gildobjanschi/ECP5_TQFP144_USB3318C_TX_AUDIO/3dmodels/DA101JC.stp

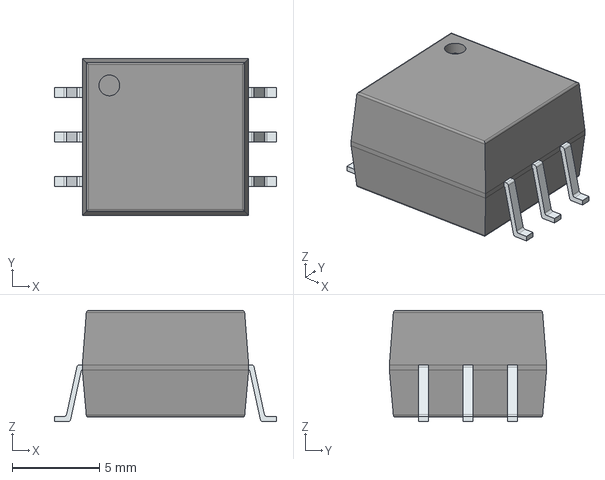
[picture p2: CAD file, 2024-07-15]
3dmodels/DA101JC.stp
12.7 x 9.00 x 6.35 mm
PinsArrayLR
