gildobjanschi/ECP5_TQFP144_USB3318C_TX_AUDIO/3dmodels/CUI_DEVICES_UJ2-BH-BL1-TH.step

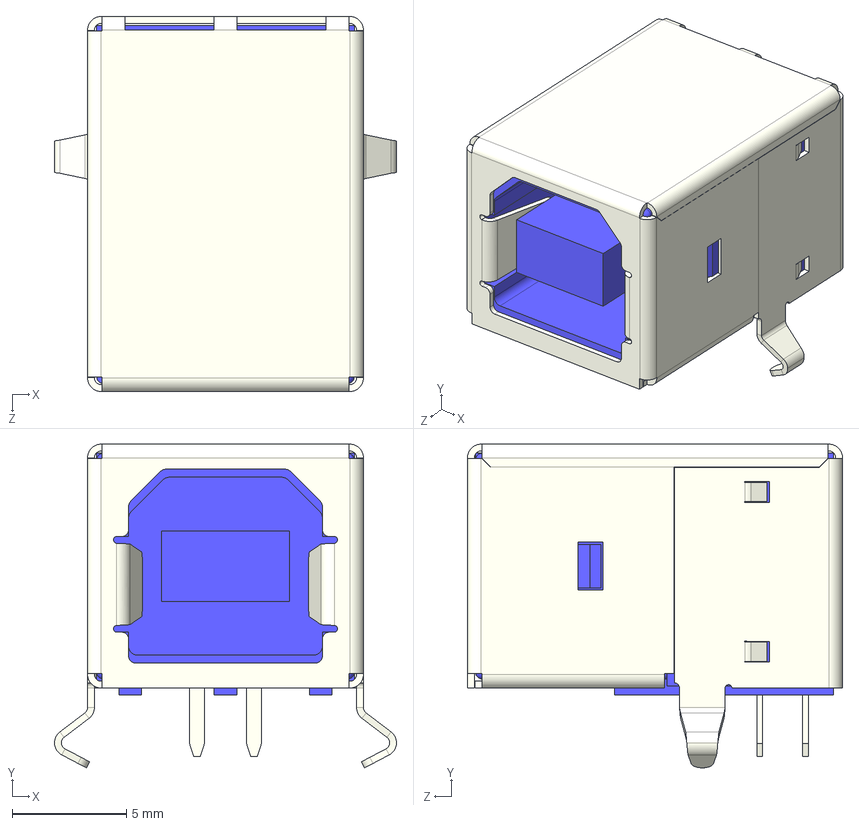
[picture p3: CAD file, 2024-07-15]
3dmodels/CUI_DEVICES_UJ2-BH-BL1-TH.step
15.0 x 14.2 x 16.5 mm
