gildobjanschi/ECP5_TQFP144_USB3318C_TX_AUDIO/3dmodels/0ZCG0075FF2C.STEP

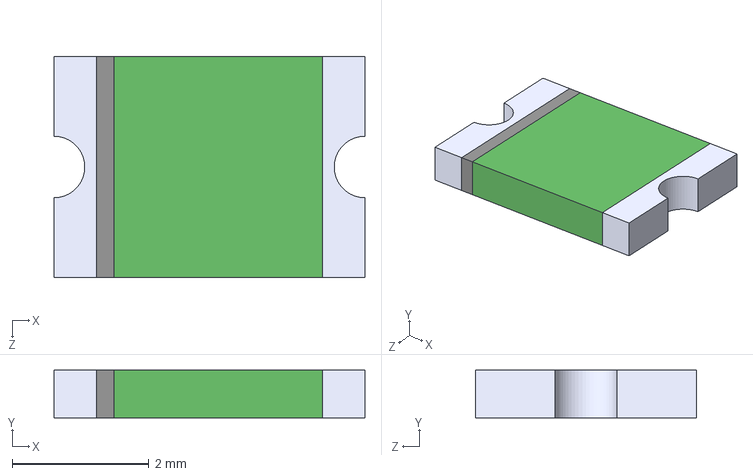
[picture p4: CAD file, 2024-07-15]
3dmodels/0ZCG0075FF2C.STEP
4.55 x 0.7 x 3.24 mm
