gildobjanschi/ECP5_TQFP144_USB3318C_TX_AUDIO/3dmodels/NC3FAAH2.STEP

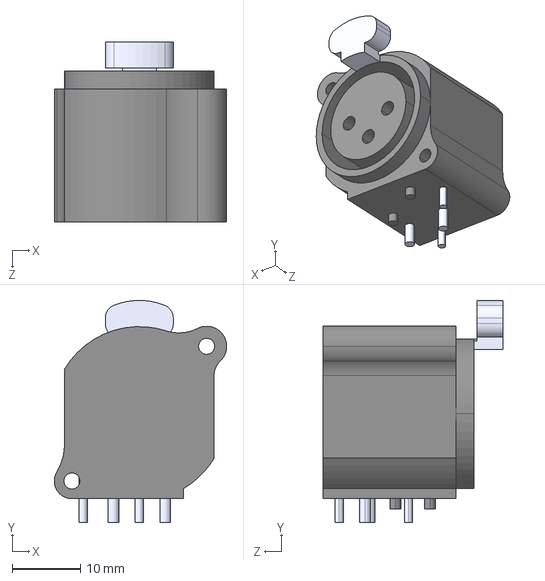
[picture p5: CAD file, 2024-07-15]
3dmodels/NC3FAAH2.STEP
25.3 x 32.6 x 26.4 mm
