gildobjanschi/ECP5_TQFP144_USB3318C_TX_AUDIO/3dmodels/CCHD-950-50-100_000_CRX.step

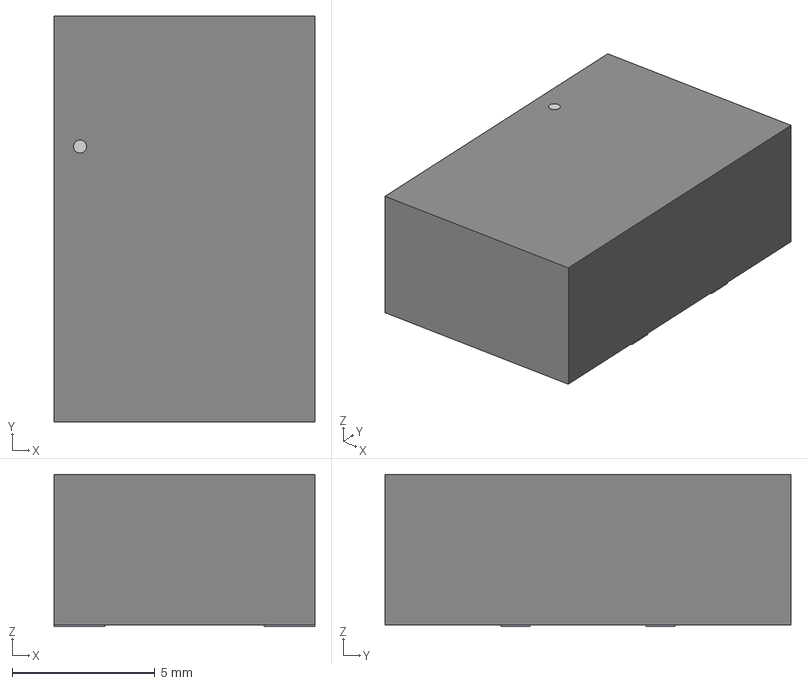
[picture p6: CAD file, 2024-07-15]
3dmodels/CCHD-950-50-100_000_CRX.step
9.14 x 14.2 x 5.34 mm
