gildobjanschi/ECP5_TQFP144_USB3318C_TX_AUDIO/3dmodels/551XX07.stp

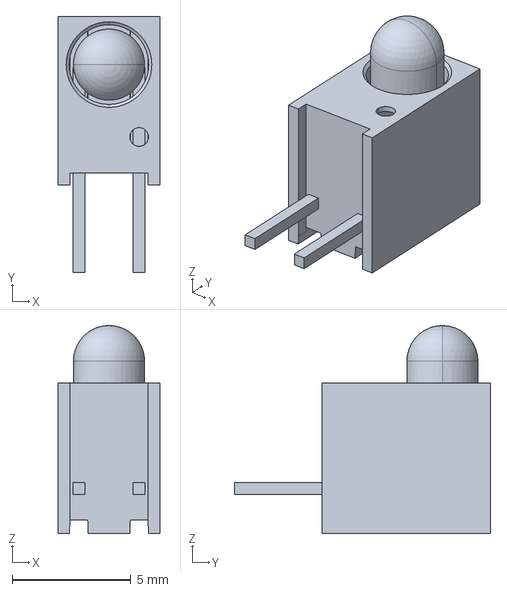
[picture p7: CAD file, 2024-07-15]
3dmodels/551XX07.stp
4.32 x 10.8 x 8.76 mm
