gildobjanschi/ECP5_TQFP144_USB3318C_TX_AUDIO/3dmodels/USB4105GFA120.step

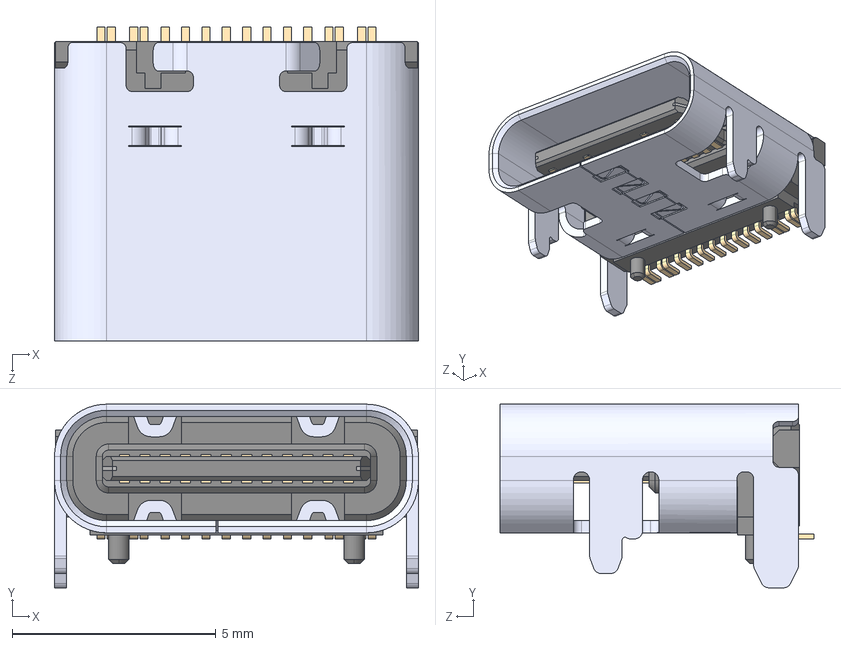
[picture p8: CAD file, 2024-07-15]
3dmodels/USB4105GFA120.step
8.94 x 4.51 x 7.71 mm
