gildobjanschi/ECP5_TQFP144_USB3318C_TX_AUDIO/3dmodels/W-PDFN-8-1EP_6x5mm_P1.27mm_EP3x3mm.step

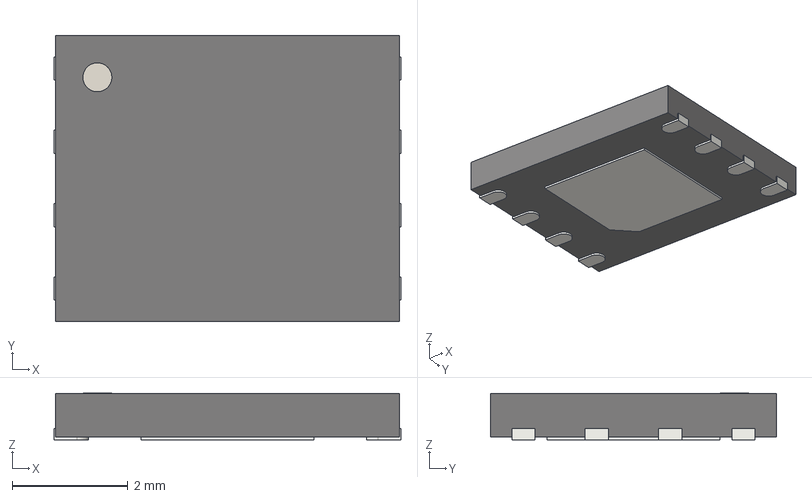
[picture p9: CAD file, 2024-07-15]
3dmodels/W-PDFN-8-1EP_6x5mm_P1.27mm_EP3x3mm.step
6.00 x 4.95 x 0.81 mm
b2c81738-8124-11ed-a8f2-acde48001122_part
b2c8199a-8124-11ed-a8f2-acde48001122_part
b2c81abc-8124-11ed-a8f2-acde48001122_part
b2c81b5c-8124-11ed-a8f2-acde48001122_part
