gildobjanschi/ECP5_TQFP144_USB3318C_TX_AUDIO/3dmodels/031-71052-1010.stp

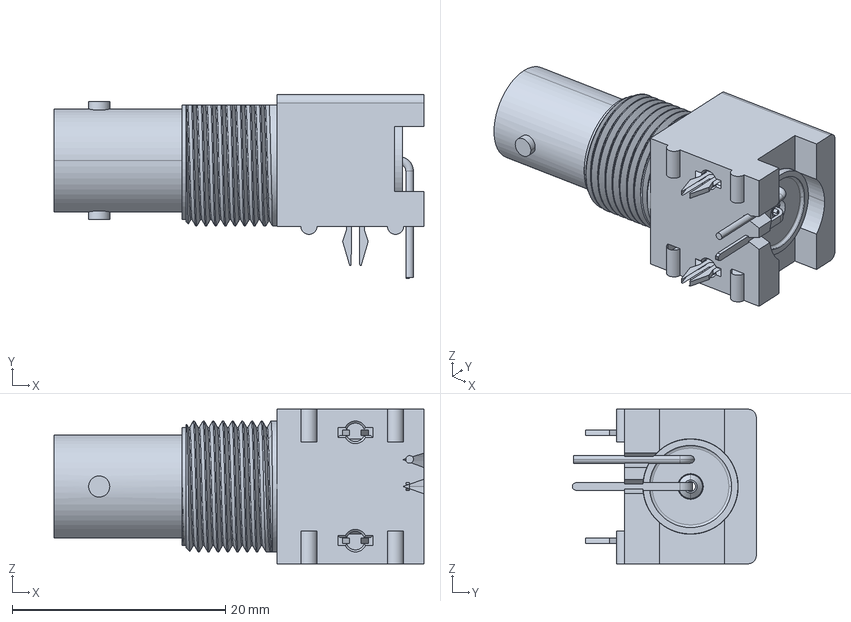
[picture p10: CAD file, 2024-07-15]
3dmodels/031-71052-1010.stp
34.7 x 17.2 x 14.5 mm
