gildobjanschi/ECP5_TQFP144_USB3318C_TX_AUDIO/3dmodels/PLR135_T10.stp

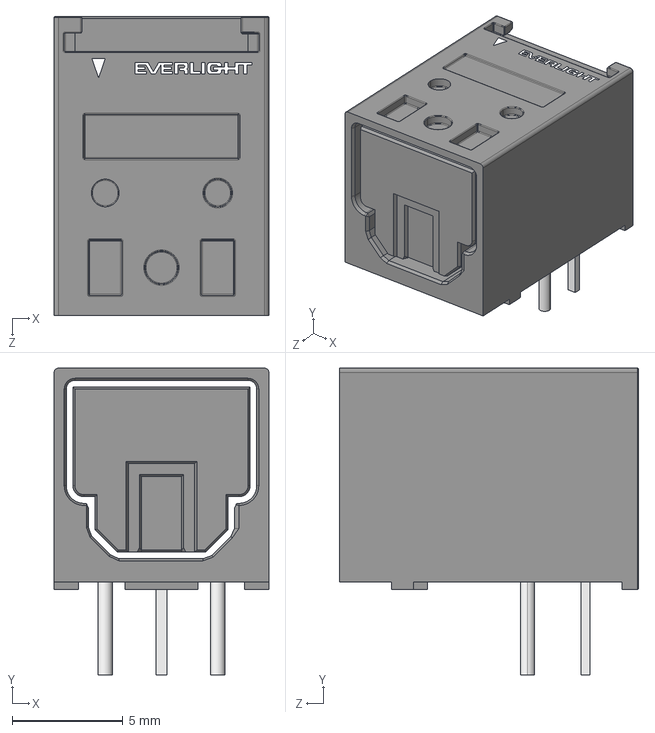
[picture p11: CAD file, 2024-07-15]
3dmodels/PLR135_T10.stp
9.70 x 13.9 x 13.5 mm
