gildobjanschi/ECP5_TQFP144_USB3318C_TX_AUDIO/3dmodels/QFN24_4X4MC_MCH.step

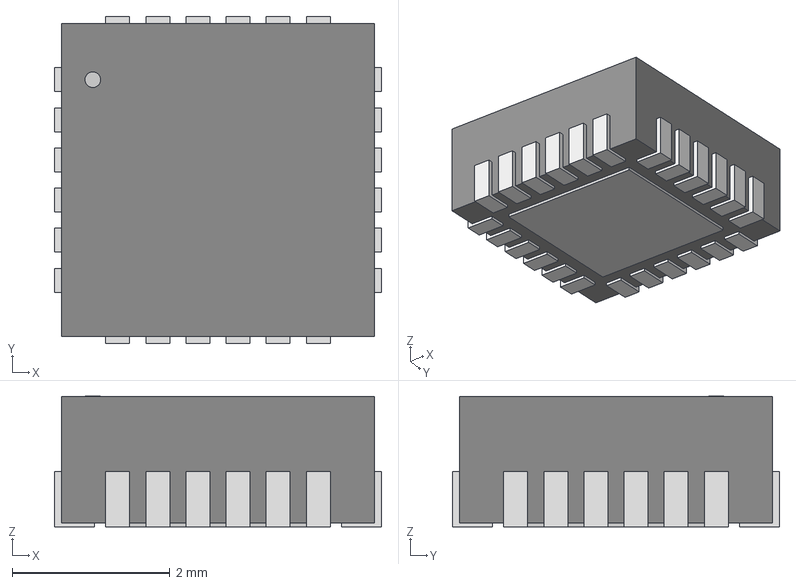
[picture p12: CAD file, 2024-07-15]
3dmodels/QFN24_4X4MC_MCH.step
4.14 x 4.14 x 1.65 mm
