gildobjanschi/ECP5_TQFP144_USB3318C_TX_AUDIO/3dmodels/10029449-001RLF.step

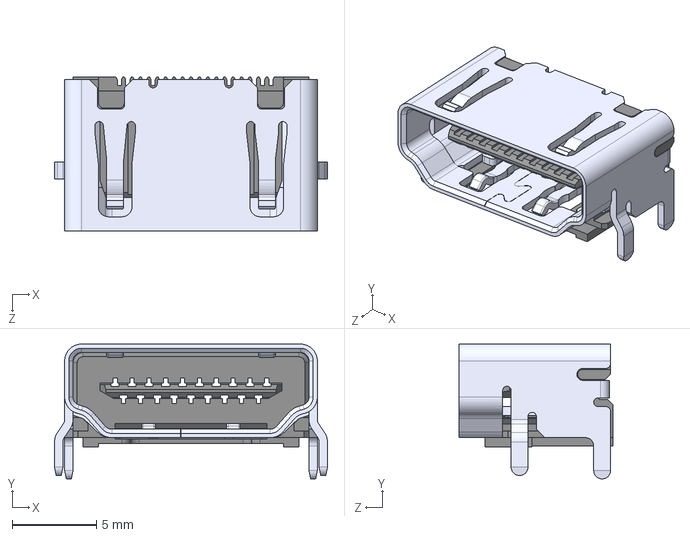
[picture p13: CAD file, 2024-07-15]
3dmodels/10029449-001RLF.step
16.2 x 8.00 x 9.15 mm
