gildobjanschi/ECP5_TQFP144_USB3318C_TX_AUDIO/kicad/ECP5 Audio Tx.pdf

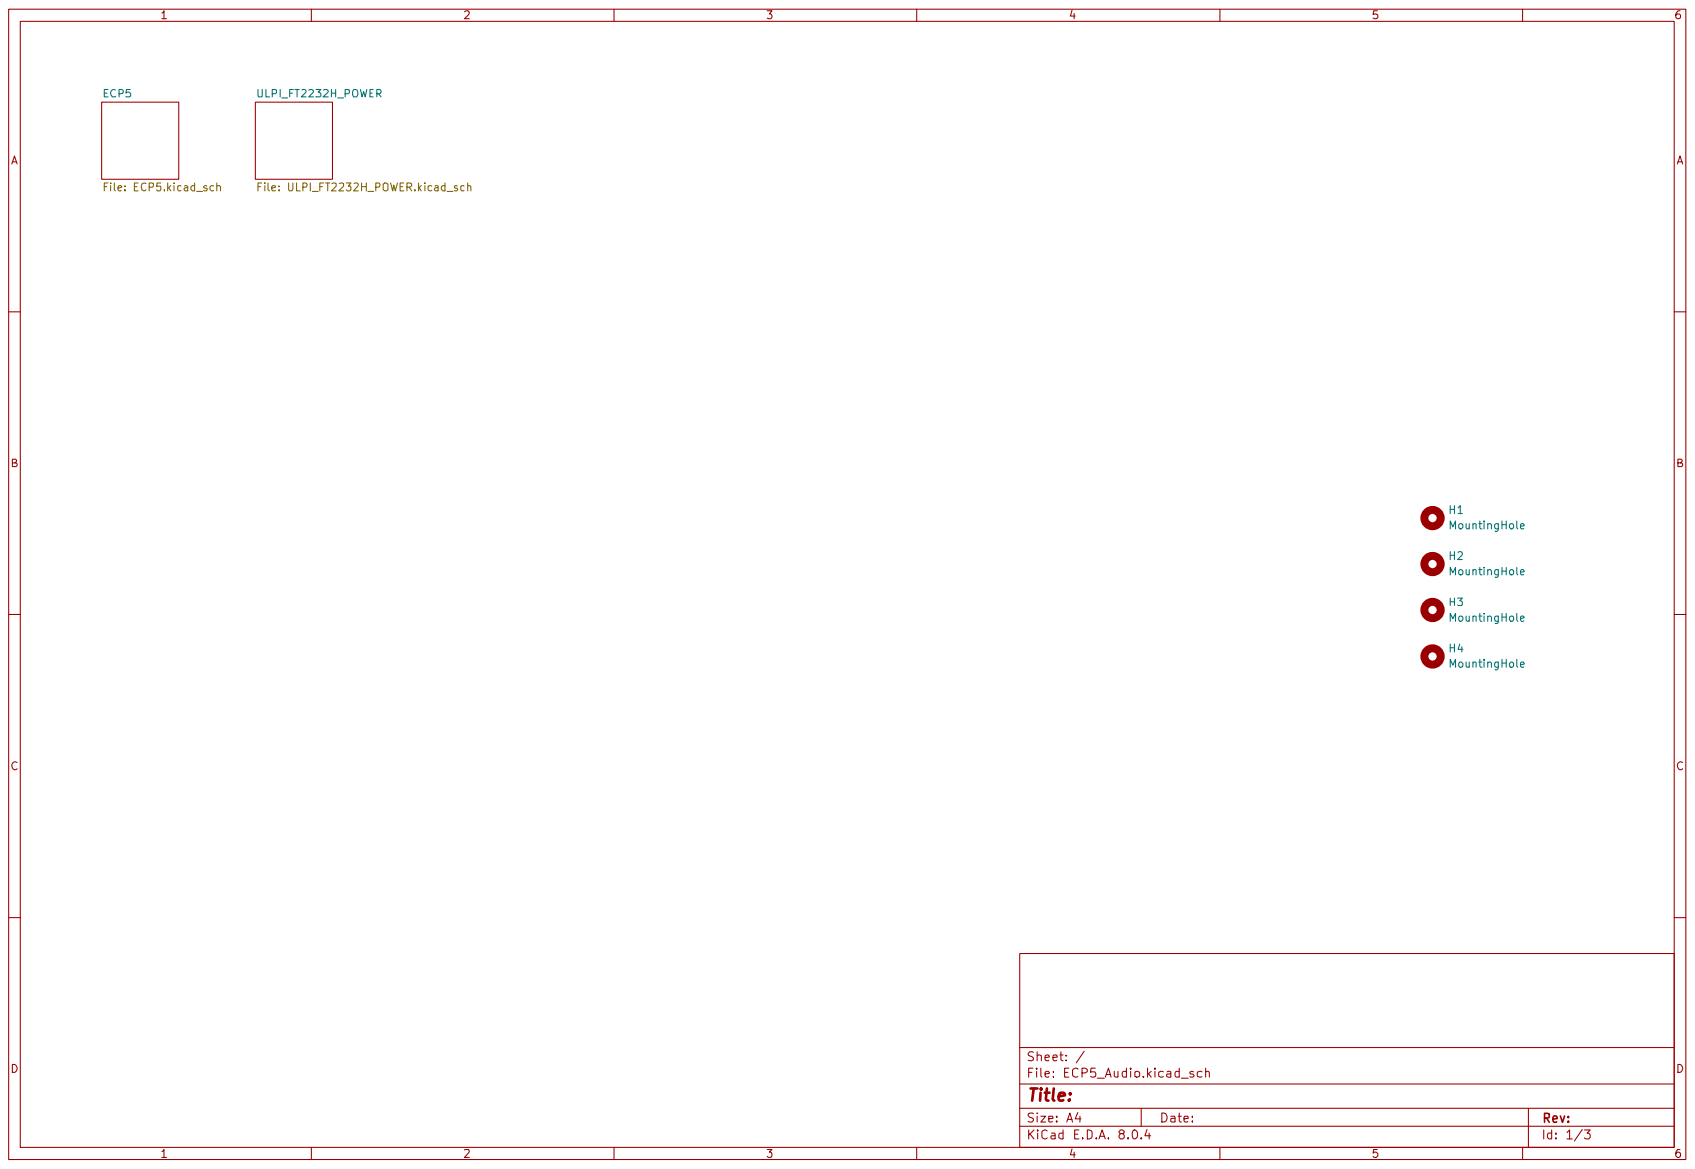
[picture p14: page 1]

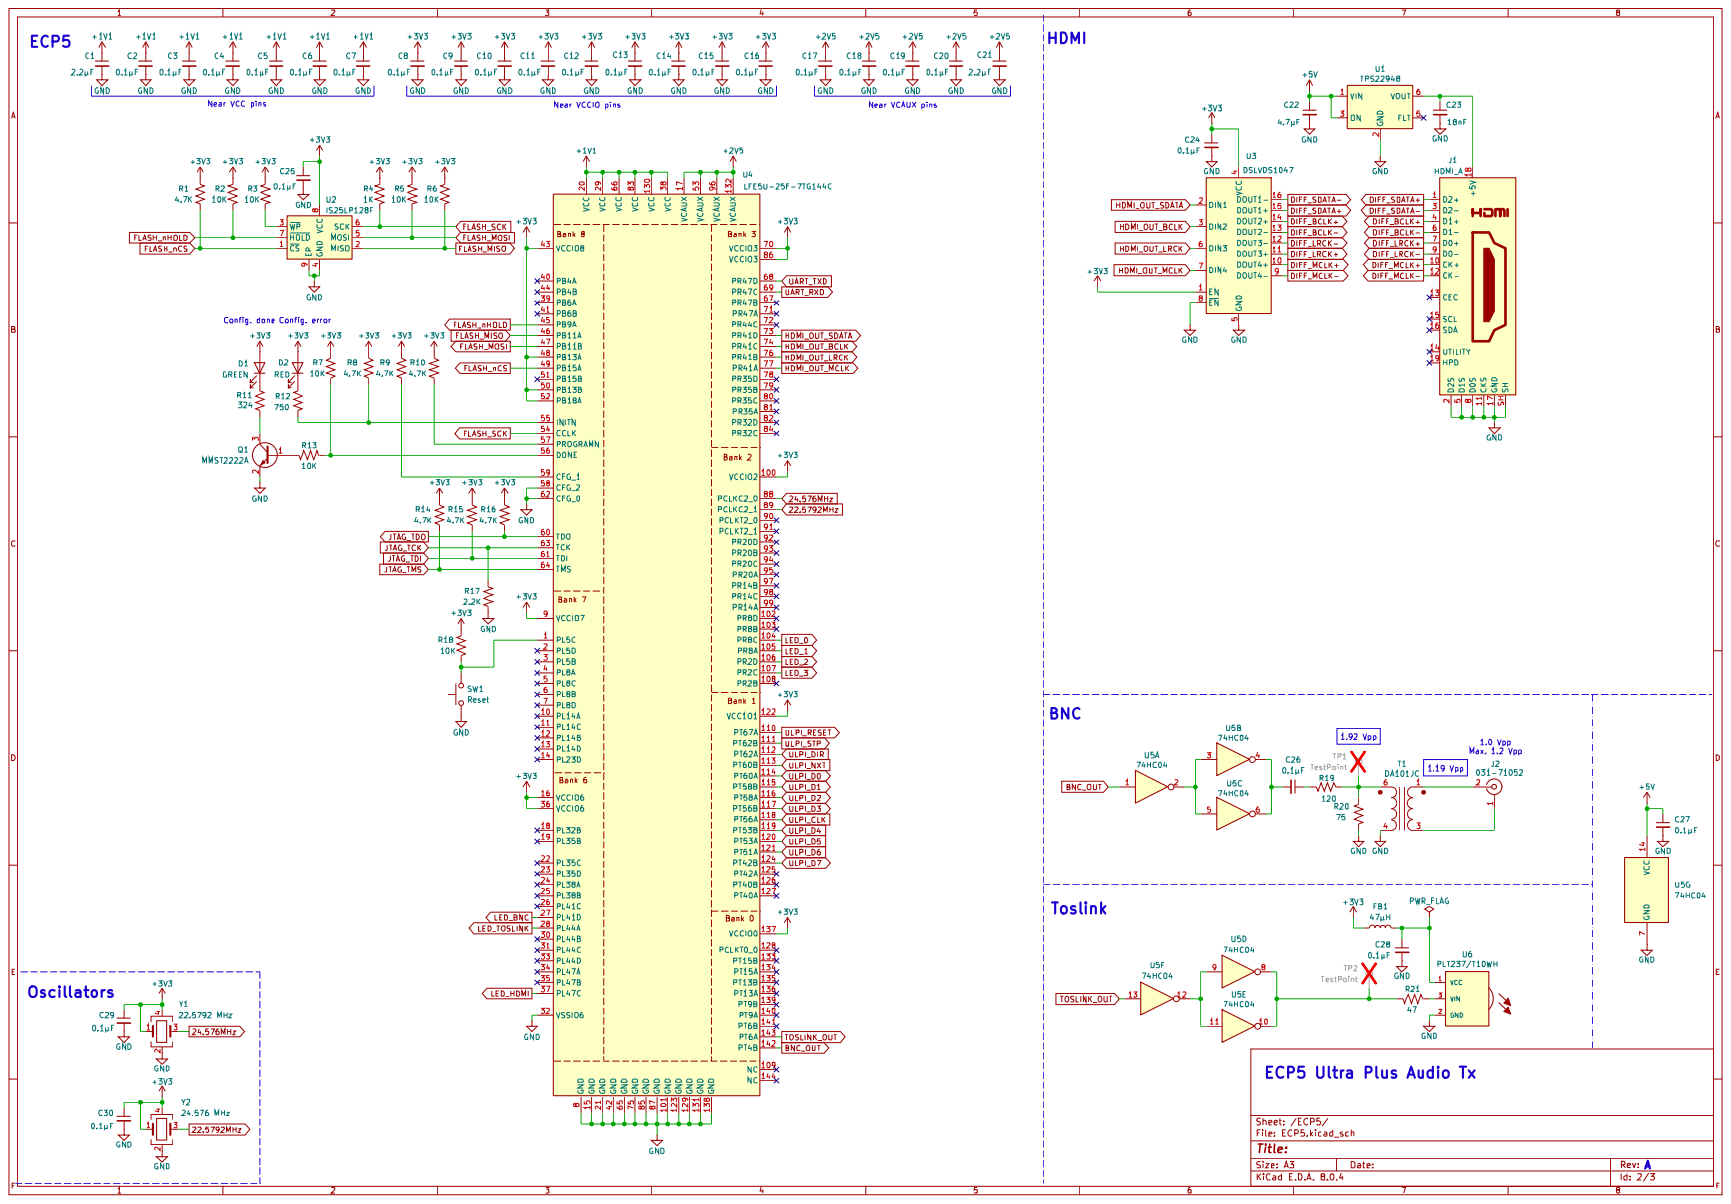
[picture p15: page 2]

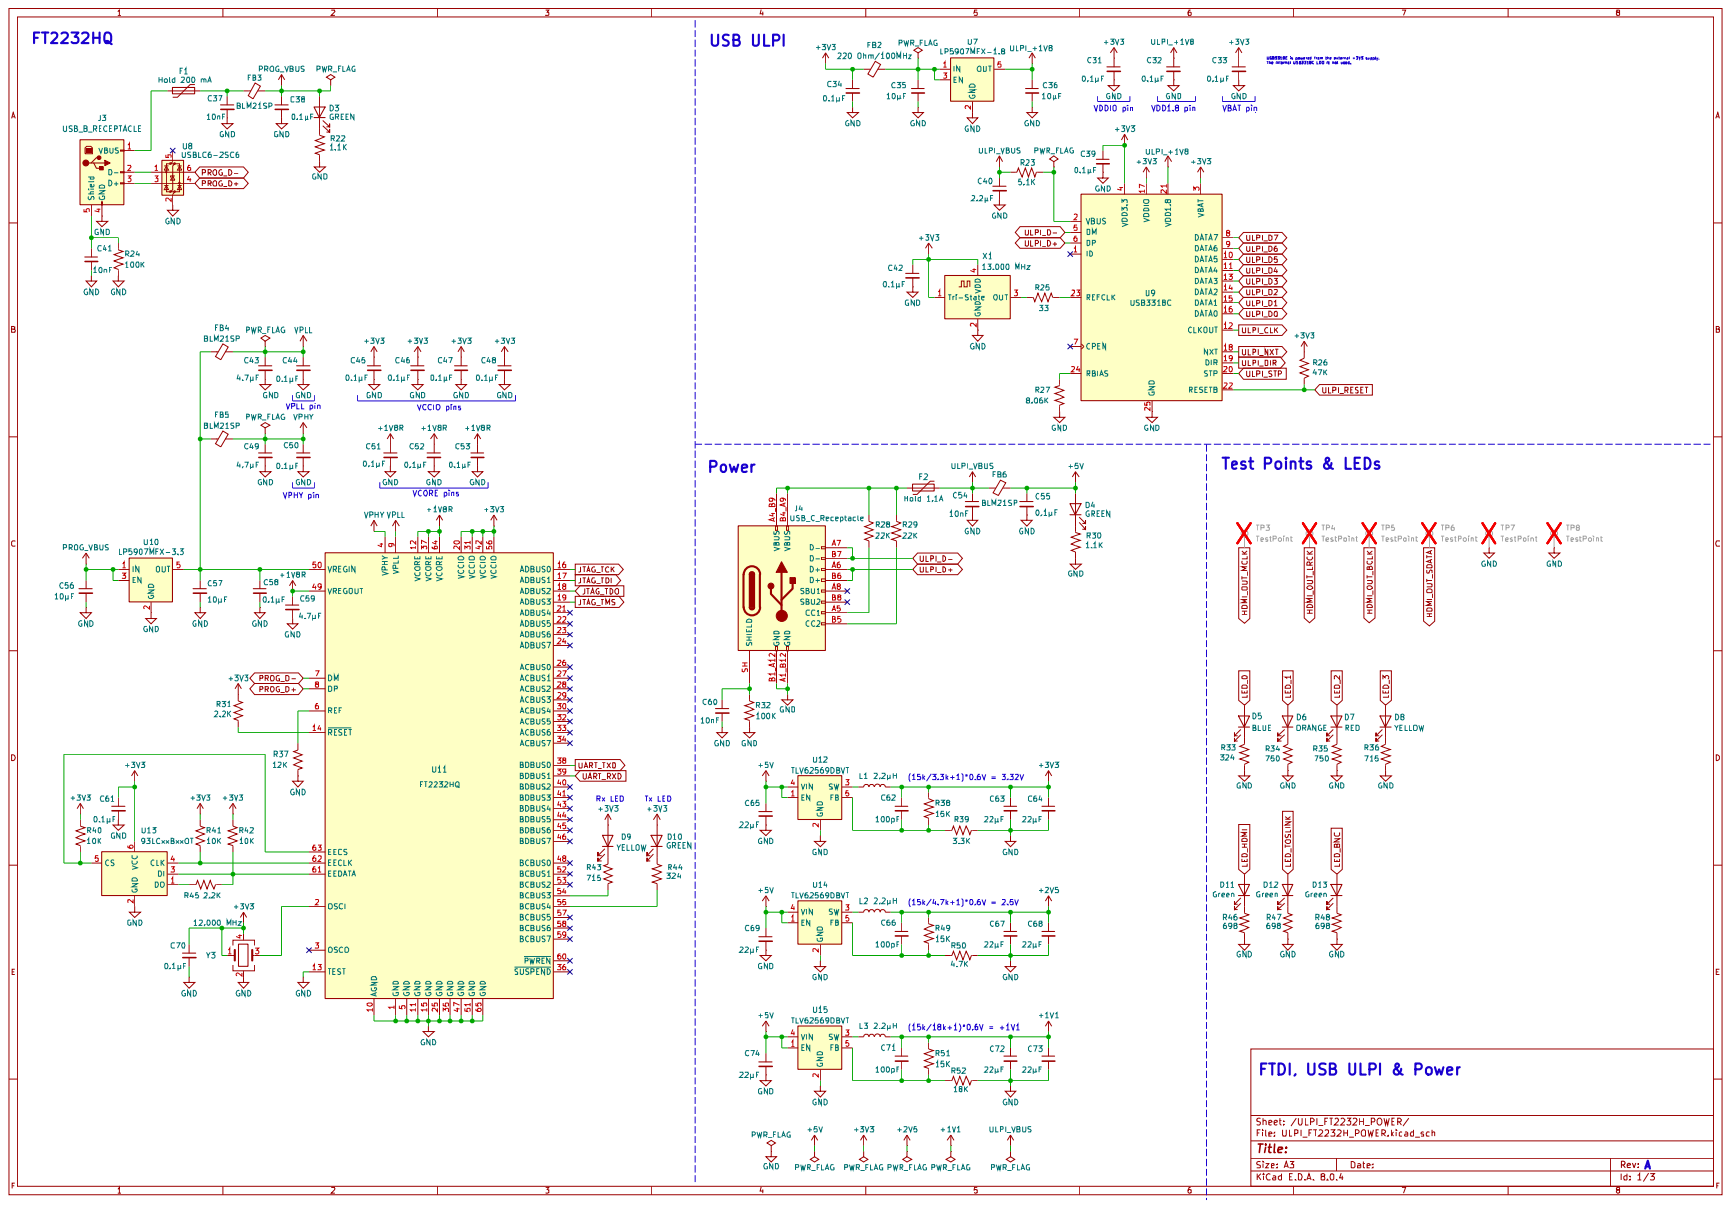
[picture p16: page 3]
