gildobjanschi/ECP5_TQFP144_USB3318C_TX_AUDIO/kicad/ECP5_Audio.kicad_pcb

## KiCad design kicad/ECP5_Audio.kicad_pcb (2024-08-13)

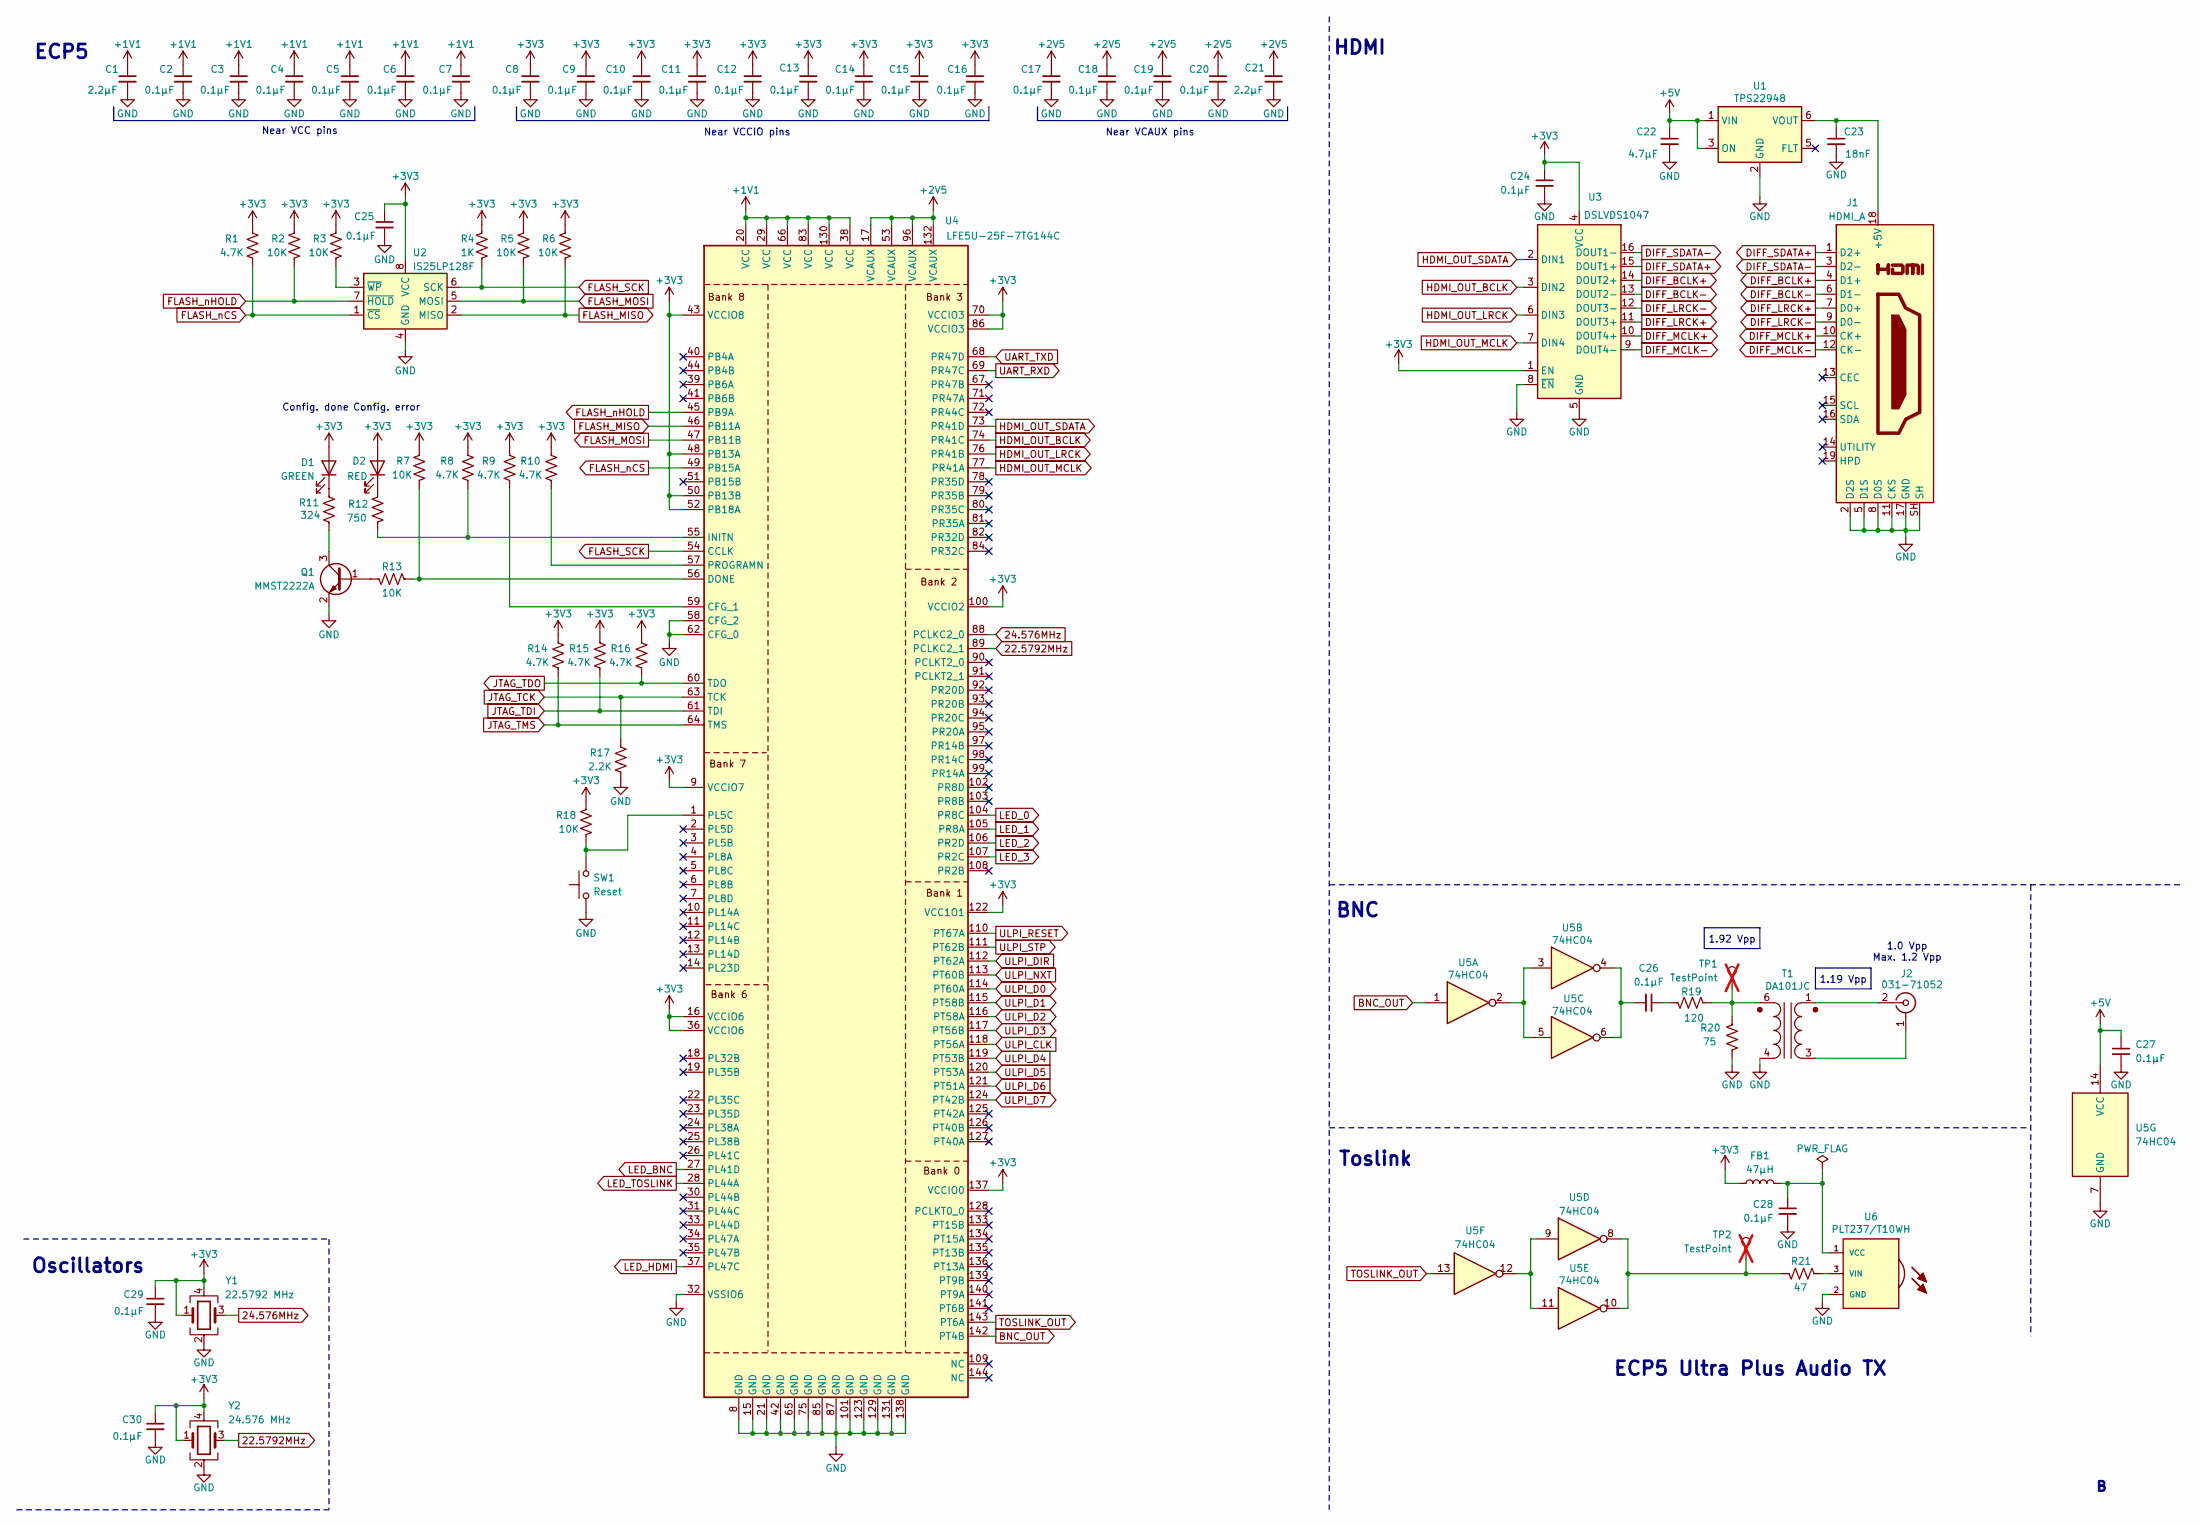
[picture p17: schematic ECP5.kicad_sch]

Parts:
C1, C21: 2.2µF; C_0603_1608Metric; MPN CL10B225KP8NNNC
C2, C3, C4, C5, C6, C7, C8, C9, C10, C11, C12, C13, C14, C15, C16, C17, C18, C19, C20, C24, C25, C26, C27, C28, C29, C30: 0.1µF; C_0603_1608Metric; MPN CL10B104KB8NNNC
C22: 4.7µF; C_0603_1608Metric; MPN CL10A475KL8NRNC
C23: 18nF; C_0603_1608Metric; MPN CC0603KRX7R9BB183
D1: GREEN; LED_0603_1608Metric; MPN APT1608LZGCK
D2: RED; LED_0603_1608Metric; MPN APT1608LSECK/J3-PRV
FB1: 47µH; L_0805_2012Metric; MPN LQM21DN470M70L
J1: HDMI_A; AMPHENOL_10029449-001RLF; MPN 10029449-001RLF
J2: 031-71052; BNC_Amphenol_031-71052_Horizontal; MPN 031-71052
Q1: MMST2222A; SOT-323_SC-70; MPN MMST2222A-7-F
R1, R8, R9, R10, R14, R15, R16: 4.7K; R_0603_1608Metric; MPN ERJ-3EKF4701V
R2, R3, R5, R6, R7, R13, R18: 10K; R_0603_1608Metric; MPN ERJ-3EKF1002V
R4: 1K; R_0603_1608Metric; MPN ERJ-3EKF1001V
R11: 324; R_0603_1608Metric; MPN ERJ-3EKF3240V
R12: 750; R_0603_1608Metric; MPN ERJ-3EKF7500V
R17: 2.2K; R_0603_1608Metric; MPN ERJ-3EKF2201V
R19: 120; R_0603_1608Metric; MPN ERJ-3EKF1200V
R20: 75; R_0603_1608Metric; MPN ERJ-3EKF75R0V
R21: 47; R_0603_1608Metric; MPN ERJ-3EKF47R0V
SW1: Reset; SW_SPST_PTS645; MPN PTS645SK43SMTR92 LFS
T1: DA101JC; DA101J_MUR; MPN DA101JC
TP1, TP2: TestPoint; TestPoint_Keystone_5000-5004_Miniature; MPN 5004; not fitted
U1: TPS22948; SOT-363_SC-70-6; MPN TPS22948DCKR
U2: IS25LP128F; WDFN-8-1EP_6x5mm_P1.27mm_EP3.4x4mm; MPN IS25LP128-JKLE
U3: DSLVDS1047; TSSOP-16-1EP_4.4x5mm_P0.65mm; MPN DSLVDS1047PWR
U4: LFE5U-25F-7TG144C; TQFP-144_20x20mm_P0.5mm; MPN LFE5U-25F-7TG144C
U5: 74HC04; TSSOP-14_4.4x5mm_P0.65mm; MPN SN74HC04PWR
U6: PLT237/T10WH; PLR135-T10; MPN PLT237/T10WH
Y1: 22.5792 MHz; CCHD-957; MPN CCHD-957-25-22.5792
Y2: 24.576 MHz; CCHD-957; MPN CCHD-957-25-24.576

Connections:
22.5792MHz: U4.89 (PCLKC2_1), Y2.3 (OUT)
24.576MHz: U4.88 (PCLKC2_0), Y1.3 (OUT)
+1V1: C1.1, C2.1, C3.1, C4.1, C5.1, C6.1, C7.1, U4.20 (VCC), U4.29 (VCC), U4.38 (VCC), U4.66 (VCC), U4.83 (VCC), U4.130 (VCC); also elsewhere on the board
+2V5: C17.1, C18.1, C19.1, C20.1, C21.1, U4.17 (VCAUX), U4.53 (VCAUX), U4.96 (VCAUX), U4.132 (VCAUX); also elsewhere on the board
+3V3: C8.1, C9.1, C10.1, C11.1, C12.1, C13.1, C14.1, C15.1, C16.1, C24.1, C25.1, C29.1, C30.1, D1.2 (A), D2.2 (A), FB1.2, R1.2, R2.2, R3.2, R4.1, R5.2, R6.2, R7.2, R8.2, R9.2, R10.2, R14.2, R15.2, R16.2, R18.2, U2.8 (VCC), U3.1 (EN), U3.4 (VCC), U4.9 (VCCIO7), U4.16 (VCCIO6), U4.36 (VCCIO6), U4.43 (VCCIO8), U4.48 (PB13A), U4.50 (PB13B), U4.52 (PB18A), U4.70 (VCCIO3), U4.86 (VCCIO3), U4.100 (VCCIO2), U4.122 (VCC1O1), U4.137 (VCCIO0), Y1.1 (E/D), Y1.4 (VCC), Y2.1 (E/D), Y2.4 (VCC); also elsewhere on the board
+5V: C22.1, C27.1, U1.1 (VIN), U1.3 (ON), U5.14 (VCC); also elsewhere on the board
BNC_OUT: U4.142 (PT4B), U5.1
DIFF_BCLK+: J1.4 (D1+), U3.14 (DOUT2+)
DIFF_BCLK-: J1.6 (D1-), U3.13 (DOUT2-)
DIFF_LRCK+: J1.7 (D0+), U3.11 (DOUT3+)
DIFF_LRCK-: J1.9 (D0-), U3.12 (DOUT3-)
DIFF_MCLK+: J1.10 (CK+), U3.10 (DOUT4+)
DIFF_MCLK-: J1.12 (CK-), U3.9 (DOUT4-)
DIFF_SDATA+: J1.1 (D2+), U3.15 (DOUT1+)
DIFF_SDATA-: J1.3 (D2-), U3.16 (DOUT1-)
FLASH_MISO: R6.1, U2.2 (MISO), U4.46 (PB11A)
FLASH_MOSI: R5.1, U2.5 (MOSI), U4.47 (PB11B)
FLASH_SCK: R4.2, U2.6 (SCK), U4.54 (CCLK)
FLASH_nCS: R1.1, U2.1 (~CS), U4.49 (PB15A)
FLASH_nHOLD: R2.1, U2.7 (~HOLD), U4.45 (PB9A)
GND: C1.2, C2.2, C3.2, C4.2, C5.2, C6.2, C7.2, C8.2, C9.2, C10.2, C11.2, C12.2, C13.2, C14.2, C15.2, C16.2, C17.2, C18.2, C19.2, C20.2, C21.2, C22.2, C23.2, C24.2, C25.2, C27.2, C28.2, C29.2, C30.2, J1.2 (D2S), J1.5 (D1S), J1.8 (D0S), J1.11 (CKS), J1.17 (GND), J1.SH, Q1.2 (E), R17.1, R20.2, SW1.1, T1.4 (SA), U1.2 (GND), U2.4 (GND), U2.9 (GND), U3.5 (GND), U3.8 (~EN), U4.8 (GND), U4.15 (GND), U4.21 (GND), U4.32 (VSSIO6), U4.42 (GND), U4.58 (CFG_2), U4.62 (CFG_0), U4.65 (GND), U4.75 (GND), U4.85 (GND), U4.87 (GND), U4.101 (GND), U4.123 (GND), U4.129 (GND), U4.131 (GND), U4.138 (GND), U5.7 (GND), U6.2 (GND), Y1.2 (GND), Y2.2 (GND); also elsewhere on the board
HDMI_OUT_BCLK: U3.3 (DIN2), U4.74 (PR41C); also elsewhere on the board
HDMI_OUT_LRCK: U3.6 (DIN3), U4.76 (PR41B); also elsewhere on the board
HDMI_OUT_MCLK: U3.7 (DIN4), U4.77 (PR41A); also elsewhere on the board
HDMI_OUT_SDATA: U3.2 (DIN1), U4.73 (PR41D); also elsewhere on the board
JTAG_TCK: R17.2, U4.63 (TCK); also elsewhere on the board
JTAG_TDI: R15.1, U4.61 (TDI); also elsewhere on the board
JTAG_TDO: R16.1, U4.60 (TDO); also elsewhere on the board
JTAG_TMS: R14.1, U4.64 (TMS); also elsewhere on the board
LED_0: U4.104 (PR8C); also elsewhere on the board
LED_1: U4.105 (PR8A); also elsewhere on the board
LED_2: U4.106 (PR2D); also elsewhere on the board
LED_3: U4.107 (PR2C); also elsewhere on the board
LED_BNC: U4.27 (PL41D); also elsewhere on the board
LED_HDMI: U4.37 (PL47C); also elsewhere on the board
LED_TOSLINK: U4.28 (PL44A); also elsewhere on the board
unnamed: C26.1, R19.2
unnamed: C26.2, U5.4, U5.6
unnamed: D1.1 (K), R11.1
unnamed: D2.1 (K), R12.1
unnamed: C23.1, J1.18 (+5V), U1.6 (VOUT)
unnamed: J2.1 (Ext), T1.3 (AB)
unnamed: J2.2 (In), T1.1 (AA)
unnamed: Q1.1 (B), R13.1
unnamed: Q1.3 (C), R11.2
unnamed: R21.2, TP2.1, U5.8, U5.10
unnamed: R19.1, R20.1, T1.6 (SB), TP1.1
unnamed: R3.1, U2.3 (~WP)
unnamed: R9.1, U4.59 (CFG_1)
unnamed: R7.1, R13.2, U4.56 (DONE)
unnamed: R8.1, R12.2, U4.55 (INITN)
unnamed: R18.1, SW1.2, U4.1 (PL5C)
unnamed: R10.1, U4.57 (PROGRAMN)
unnamed: U5.2, U5.3, U5.5
unnamed: U5.9, U5.11, U5.12
unnamed: C28.1, FB1.1, U6.1 (VCC)
unnamed: R21.1, U6.3 (VIN)
TOSLINK_OUT: U4.143 (PT6A), U5.13
UART_RXD: U4.69 (PR47C); also elsewhere on the board
UART_TXD: U4.68 (PR47D); also elsewhere on the board
ULPI_CLK: U4.118 (PT56A); also elsewhere on the board
ULPI_D0: U4.114 (PT60A); also elsewhere on the board
ULPI_D1: U4.115 (PT58B); also elsewhere on the board
ULPI_D2: U4.116 (PT58A); also elsewhere on the board
ULPI_D3: U4.117 (PT56B); also elsewhere on the board
ULPI_D4: U4.119 (PT53B); also elsewhere on the board
ULPI_D5: U4.120 (PT53A); also elsewhere on the board
ULPI_D6: U4.121 (PT51A); also elsewhere on the board
ULPI_D7: U4.124 (PT42B); also elsewhere on the board
ULPI_DIR: U4.112 (PT62A); also elsewhere on the board
ULPI_NXT: U4.113 (PT60B); also elsewhere on the board
ULPI_RESET: U4.110 (PT67A); also elsewhere on the board
ULPI_STP: U4.111 (PT62B); also elsewhere on the board

Notes on the sheet:
ECP5
1.92 Vpp
Toslink
Config. error
1.19 Vpp
HDMI
BNC
ECP5 Ultra Plus Audio TX
Near VCCIO pins
1.0 Vpp Max. 1.2 Vpp
Config. done
Near VCAUX pins
Oscillators
Near VCC pins

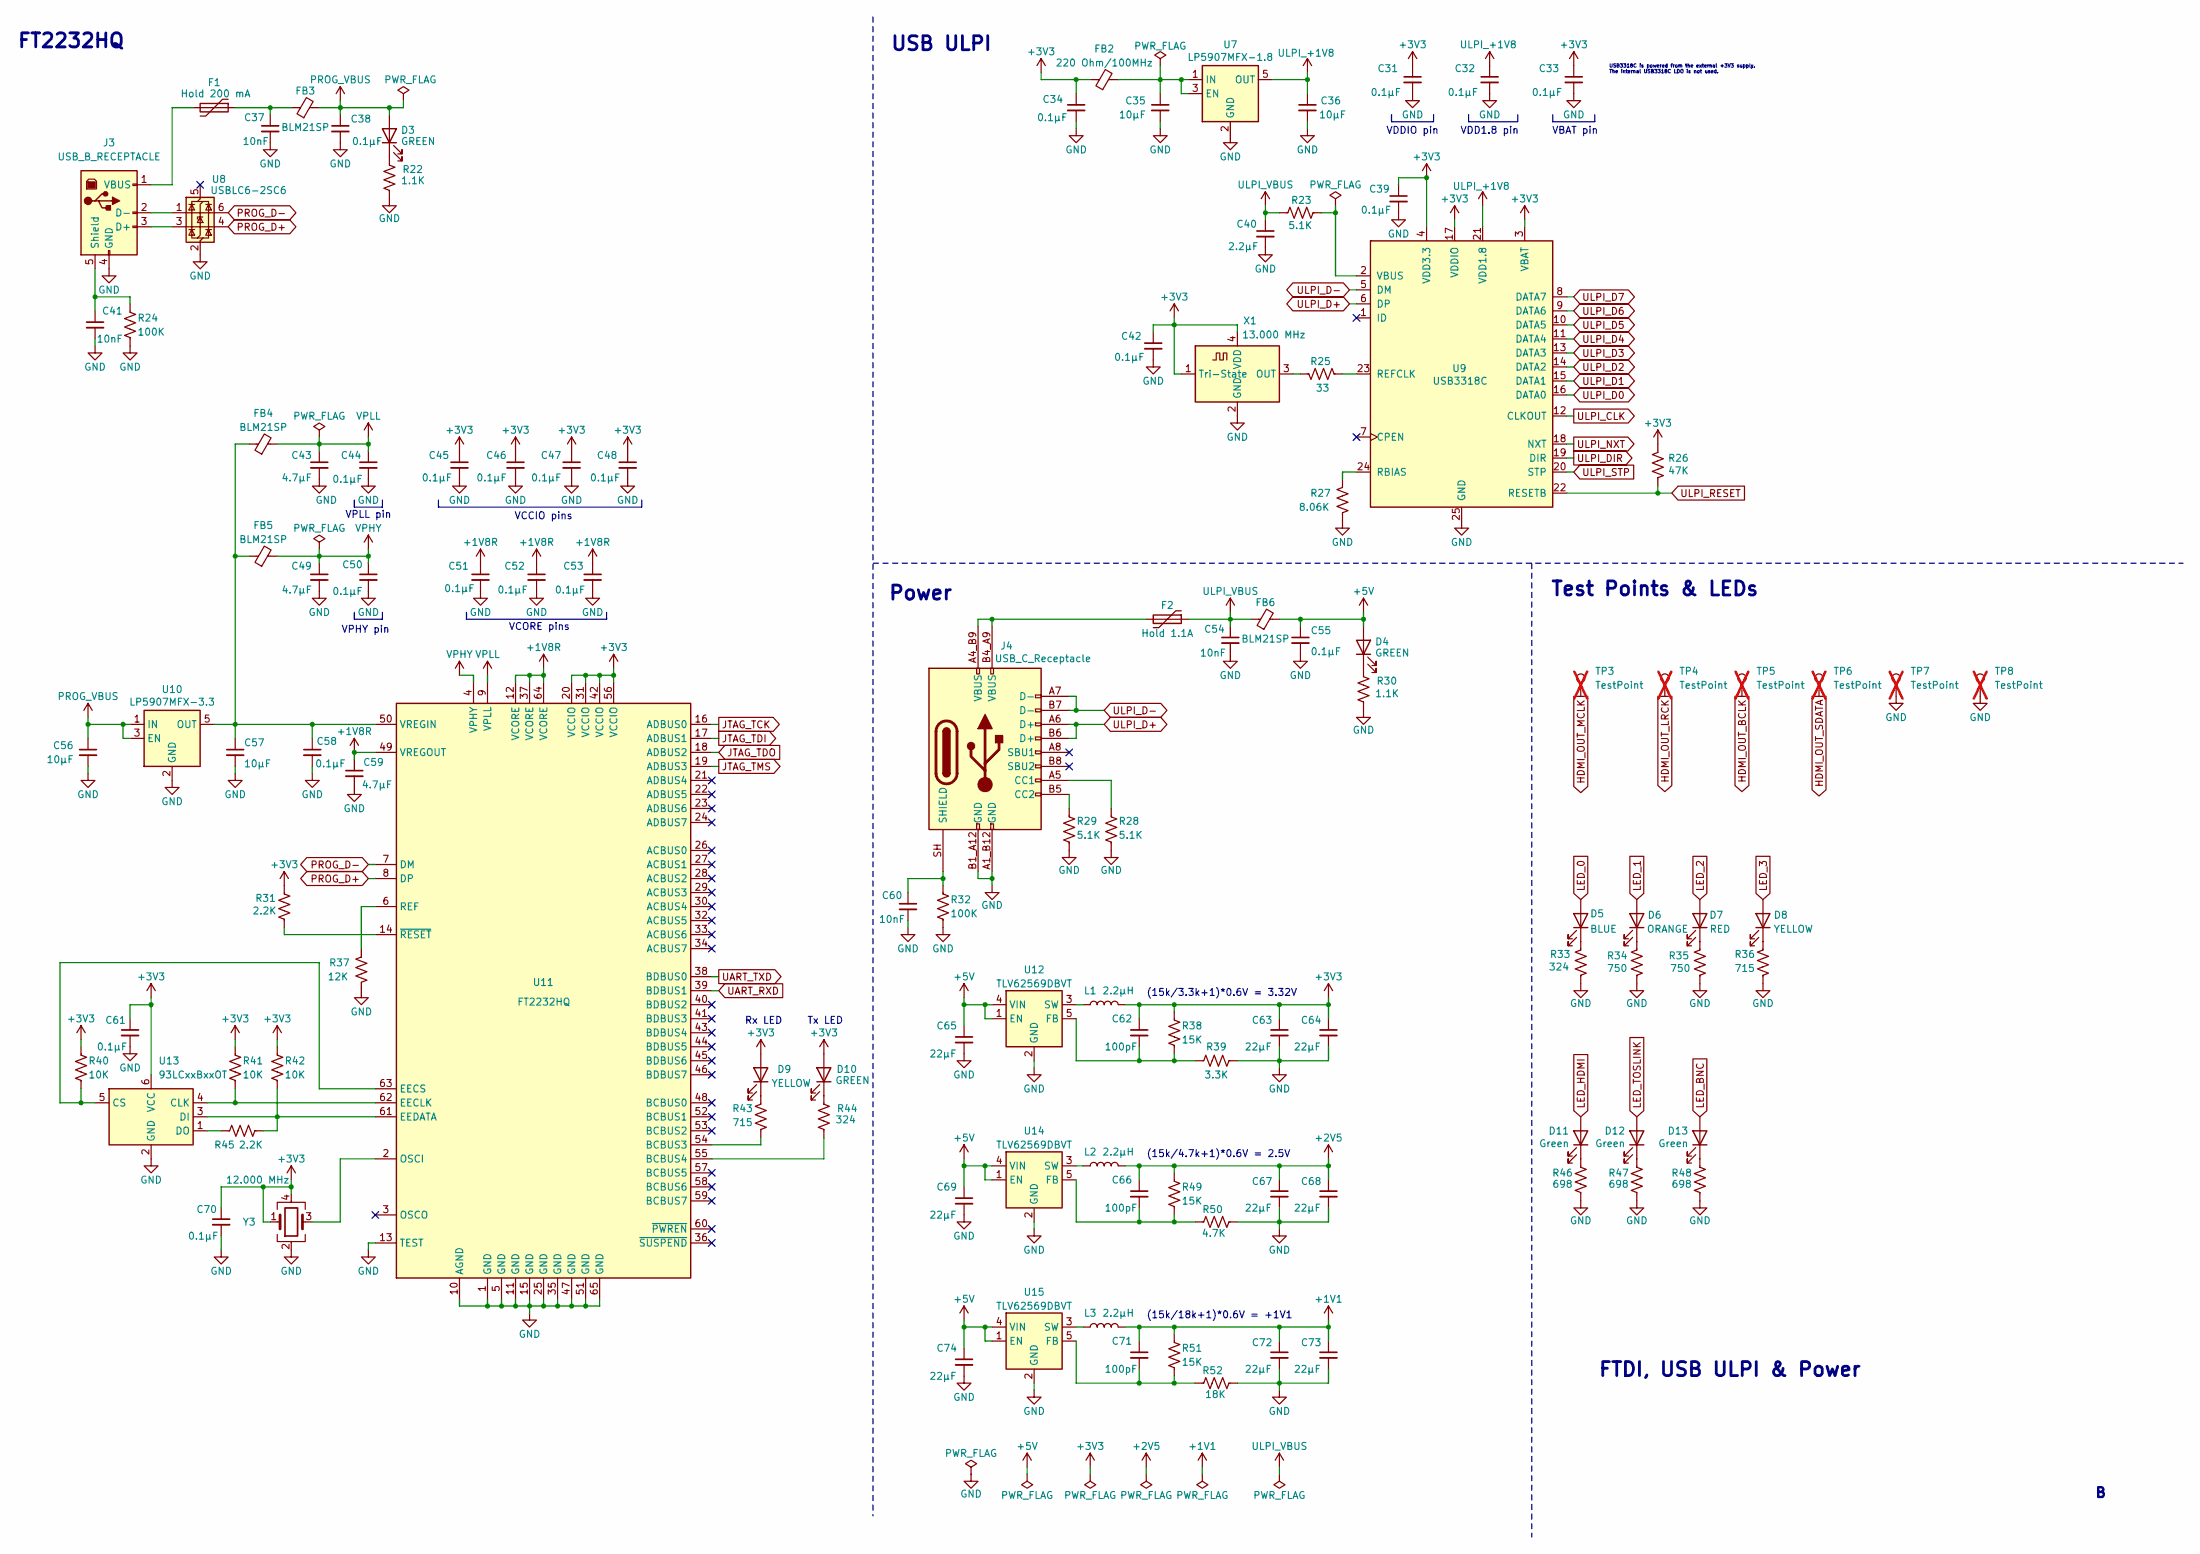
[picture p18: schematic ULPI_FT2232H_POWER.kicad_sch]

Parts:
C31, C32, C33, C34, C38, C39, C42, C44, C45, C46, C47, C48, C50, C51, C52, C53, C55, C58, C61, C70: 0.1µF; C_0603_1608Metric; MPN CL10B104KB8NNNC
C35, C36, C56, C57: 10µF; C_0805_2012Metric; MPN CL21B106KOQNNNE
C37, C41, C54, C60: 10nF; C_0603_1608Metric; MPN CL10B103KB8NNNC
C40: 2.2µF; C_0603_1608Metric; MPN CL10B225KP8NNNC
C43, C49, C59: 4.7µF; C_0603_1608Metric; MPN CL10A475KL8NRNC
C62, C66, C71: 100pF; C_0603_1608Metric; MPN CL10C101FB81PNC
C63, C64, C65, C67, C68, C69, C72, C73, C74: 22µF; C_0805_2012Metric; MPN CL21A226KOQNNNE
D3, D4, D10: GREEN; LED_0603_1608Metric; MPN APT1608LZGCK
D5: BLUE; LED_0603_1608Metric; MPN APT1608LVBC/D
D6: ORANGE; LED_0603_1608Metric; MPN APT1608LSECK/J4-PRV
D7: RED; LED_0603_1608Metric; MPN APT1608LSECK/J3-PRV
D8, D9: YELLOW; LED_0603_1608Metric; MPN APT1608LSYCK
D11, D12, D13: Green; Dialight_551-0307F; MPN 5511307F
F1: Hold 200 mA; Bel_Fuse_1812; MPN 0ZCG0020AF2C
F2: Hold 1.1A; Bel_Fuse_1812; MPN 0ZCG0110AF2C
FB2: 220 Ohm/100MHz; L_0603_1608Metric; MPN MPZ1608S221ATA00
FB3, FB4, FB5, FB6: BLM21SP; L_0805_2012Metric; MPN BLM21SP601SN1D
J3: USB_B_RECEPTACLE; CUI_UJ2-BH-BL1-TH; MPN UJ2-BH-BL1-TH
J4: USB_C_Receptacle; GCT_USB4105GFA120; MPN USB4105-GF-A-120
L1, L2, L3: 2.2µH; L_1210_3225Metric; MPN DFE322512F-2R2M=P2
R22, R30: 1.1K; R_0603_1608Metric; MPN ERJ-3EKF1101V
R23, R28, R29: 5.1K; R_0603_1608Metric; MPN ERJ-3EKF5101V
R24, R32: 100K; R_0603_1608Metric; MPN ERJ-3EKF1003V
R25: 33; R_0603_1608Metric; MPN ERJ-3EKF33R0V
R26: 47K; R_0603_1608Metric; MPN ERJ-3EKF4702V
R27: 8.06K; R_0603_1608Metric; MPN ERJ-3EKF8061V
R31, R45: 2.2K; R_0603_1608Metric; MPN ERJ-3EKF2201V
R33, R44: 324; R_0603_1608Metric; MPN ERJ-3EKF3240V
R34, R35: 750; R_0603_1608Metric; MPN ERJ-3EKF7500V
R36, R43: 715; R_0603_1608Metric; MPN ERJ-3EKF7150V
R37: 12K; R_0603_1608Metric; MPN ERJ-3EKF1202V
R38, R49, R51: 15K; R_0603_1608Metric; MPN ERJ-3EKF1502V
R39: 3.3K; R_0603_1608Metric; MPN ERJ-3EKF3301V
R40, R41, R42: 10K; R_0603_1608Metric; MPN ERJ-3EKF1002V
R46, R47, R48: 698; R_0603_1608Metric; MPN ERJ-3EKF6980V
R50: 4.7K; R_0603_1608Metric; MPN ERJ-3EKF4701V
R52: 18K; R_0603_1608Metric; MPN ERJ-3EKF1802V
TP3, TP4, TP5, TP6: TestPoint; TestPoint_Keystone_5000-5004_Miniature; MPN 5004; not fitted
TP7, TP8: TestPoint; TestPoint_Keystone_5000-5004_Miniature; MPN 5001; not fitted
U7: LP5907MFX-1.8; SOT-23-5; MPN LP5907MFX-1.8/NOPB
U8: USBLC6-2SC6; SOT-23-6; MPN USBLC6-2SC6
U9: USB3318C; QFN-24-1EP_4x4mm_P0.5mm_EP2.65x2.65mm_ThermalVias; MPN USB3318C-CP-TR
U10: LP5907MFX-3.3; SOT-23-5; MPN LP5907MFX-3.3/NOPB
U11: FT2232HQ; QFN-64-1EP_9x9mm_P0.5mm_EP4.35x4.35mm; MPN FT2232HQ-REEL
U12, U14, U15: TLV62569DBVT; SOT-23-5; MPN TLV62569DBVT
U13: 93LCxxBxxOT; SOT-23-6; MPN 93LC56BT-I/OT
X1: 13.000 MHz; Oscillator_SMD_ECS_2520MV-xxx-xx-4Pin_2.5x2.0mm; MPN ECS-2520MV-130-BN-TR
Y3: 12.000 MHz; Oscillator_SMD_ECS_2520MV-xxx-xx-4Pin_2.5x2.0mm; MPN SG-210STF 12.0000ML3

Connections:
+1V1: C71.1, C72.1, C73.1, L3.2, R51.1; also elsewhere on the board
+1V8R: C51.1, C52.1, C53.1, C59.1, U11.12 (VCORE), U11.37 (VCORE), U11.49 (VREGOUT), U11.64 (VCORE)
+2V5: C66.1, C67.1, C68.1, L2.2, R49.1; also elsewhere on the board
+3V3: C31.1, C33.1, C34.1, C39.1, C42.1, C45.1, C46.1, C47.1, C48.1, C61.1, C62.1, C63.1, C64.1, C70.1, D9.2 (A), D10.2 (A), FB2.1, L1.2, R26.2, R31.1, R38.1, R40.1, R41.1, R42.1, U9.3 (VBAT), U9.4 (VDD3.3), U9.17 (VDDIO), U11.20 (VCCIO), U11.31 (VCCIO), U11.42 (VCCIO), U11.56 (VCCIO), U13.6 (VCC), X1.1 (Tri-State), X1.4 (VDD), Y3.1, Y3.4; also elsewhere on the board
+5V: C55.1, C65.1, C69.1, C74.1, D4.2 (A), FB6.2, U12.1 (EN), U12.4 (VIN), U14.1 (EN), U14.4 (VIN), U15.1 (EN), U15.4 (VIN); also elsewhere on the board
GND: C31.2, C32.2, C33.2, C34.2, C35.2, C36.2, C37.2, C38.2, C39.2, C40.2, C41.2, C42.2, C43.2, C44.2, C45.2, C46.2, C47.2, C48.2, C49.2, C50.2, C51.2, C52.2, C53.2, C54.2, C55.2, C56.2, C57.2, C58.2, C59.2, C60.2, C61.2, C63.2, C64.2, C65.2, C67.2, C68.2, C69.2, C70.2, C72.2, C73.2, C74.2, J3.4 (GND), J4.A1_B12 (GND), J4.B1_A12 (GND), R22.2, R24.2, R27.2, R28.2, R29.2, R30.2, R32.2, R33.2, R34.2, R35.2, R36.2, R37.2, R39.2, R46.2, R47.2, R48.2, R50.2, R52.2, TP7.1, TP8.1, U7.2 (GND), U8.2 (GND), U9.25 (GND), U10.2 (GND), U11.1 (GND), U11.5 (GND), U11.10 (AGND), U11.11 (GND), U11.13 (TEST), U11.15 (GND), U11.25 (GND), U11.35 (GND), U11.47 (GND), U11.51 (GND), U11.65 (GND), U12.2 (GND), U13.2 (GND), U14.2 (GND), U15.2 (GND), X1.2 (GND), Y3.2; also elsewhere on the board
HDMI_OUT_BCLK: TP5.1; also elsewhere on the board
HDMI_OUT_LRCK: TP4.1; also elsewhere on the board
HDMI_OUT_MCLK: TP3.1; also elsewhere on the board
HDMI_OUT_SDATA: TP6.1; also elsewhere on the board
JTAG_TCK: U11.16 (ADBUS0); also elsewhere on the board
JTAG_TDI: U11.17 (ADBUS1); also elsewhere on the board
JTAG_TDO: U11.18 (ADBUS2); also elsewhere on the board
JTAG_TMS: U11.19 (ADBUS3); also elsewhere on the board
LED_0: D5.2 (A); also elsewhere on the board
LED_1: D6.2 (A); also elsewhere on the board
LED_2: D7.2 (A); also elsewhere on the board
LED_3: D8.2 (A); also elsewhere on the board
LED_BNC: D13.2 (A); also elsewhere on the board
LED_HDMI: D11.2 (A); also elsewhere on the board
LED_TOSLINK: D12.2 (A); also elsewhere on the board
unnamed: C37.1, F1.1, FB3.1
unnamed: D3.1 (K), R22.1
unnamed: D4.1 (K), R30.1
unnamed: D5.1 (K), R33.1
unnamed: D6.1 (K), R34.1
unnamed: D7.1 (K), R35.1
unnamed: D8.1 (K), R36.1
unnamed: D9.1 (K), R43.1
unnamed: D10.1 (K), R44.1
unnamed: D11.1 (K), R46.1
unnamed: D12.1 (K), R47.1
unnamed: D13.1 (K), R48.1
unnamed: F2.2, J4.A4_B9 (VBUS), J4.B4_A9 (VBUS)
unnamed: J3.3 (D+), U8.3 (I/O2)
unnamed: J3.2 (D-), U8.1 (I/O1)
unnamed: C41.1, J3.5 (Shield), R24.1
unnamed: F1.2, J3.1 (VBUS)
unnamed: J4.A5 (CC1), R28.1
unnamed: J4.B5 (CC2), R29.1
unnamed: C60.1, J4.SH (SHIELD), R32.1
unnamed: C35.1, FB2.2, U7.1 (IN), U7.3 (EN)
unnamed: R27.1, U9.24 (RBIAS)
unnamed: R25.2, U9.23 (REFCLK)
unnamed: R23.1, U9.2 (VBUS)
unnamed: C57.1, C58.1, FB4.1, FB5.1, U10.5 (OUT), U11.50 (VREGIN)
unnamed: R43.2, U11.54 (BCBUS3)
unnamed: R44.2, U11.55 (BCBUS4)
unnamed: R41.2, U11.62 (EECLK), U13.4 (CLK)
unnamed: R40.2, U11.63 (EECS), U13.5 (CS)
unnamed: R42.2, R45.2, U11.61 (EEDATA), U13.3 (DI)
unnamed: U11.2 (OSCI), Y3.3
unnamed: R37.1, U11.6 (REF)
unnamed: R31.2, U11.14 (~RESET)
unnamed: C62.2, R38.2, R39.1, U12.5 (FB)
unnamed: L1.1, U12.3 (SW)
unnamed: R45.1, U13.1 (DO)
unnamed: C66.2, R49.2, R50.1, U14.5 (FB)
unnamed: L2.1, U14.3 (SW)
unnamed: C71.2, R51.2, R52.1, U15.5 (FB)
unnamed: L3.1, U15.3 (SW)
unnamed: R25.1, X1.3 (OUT)
PROG_D+: U8.4 (I/O2), U11.8 (DP)
PROG_D-: U8.6 (I/O1), U11.7 (DM)
PROG_VBUS: C38.1, C56.1, D3.2 (A), FB3.2, U10.1 (IN), U10.3 (EN)
UART_RXD: U11.39 (BDBUS1); also elsewhere on the board
UART_TXD: U11.38 (BDBUS0); also elsewhere on the board
ULPI_+1V8: C32.1, C36.1, U7.5 (OUT), U9.21 (VDD1.8)
ULPI_CLK: U9.12 (CLKOUT); also elsewhere on the board
ULPI_D0: U9.16 (DATA0); also elsewhere on the board
ULPI_D1: U9.15 (DATA1); also elsewhere on the board
ULPI_D2: U9.14 (DATA2); also elsewhere on the board
ULPI_D3: U9.13 (DATA3); also elsewhere on the board
ULPI_D4: U9.11 (DATA4); also elsewhere on the board
ULPI_D5: U9.10 (DATA5); also elsewhere on the board
ULPI_D6: U9.9 (DATA6); also elsewhere on the board
ULPI_D7: U9.8 (DATA7); also elsewhere on the board
ULPI_D+: J4.A6 (D+), J4.B6 (D+), U9.6 (DP)
ULPI_D-: J4.A7 (D-), J4.B7 (D-), U9.5 (DM)
ULPI_DIR: U9.19 (DIR); also elsewhere on the board
ULPI_NXT: U9.18 (NXT); also elsewhere on the board
ULPI_RESET: R26.1, U9.22 (RESETB); also elsewhere on the board
ULPI_STP: U9.20 (STP); also elsewhere on the board
ULPI_VBUS: C40.1, C54.1, F2.1, FB6.1, R23.2
VPHY: C49.1, C50.1, FB5.2, U11.4 (VPHY)
VPLL: C43.1, C44.1, FB4.2, U11.9 (VPLL)

Notes on the sheet:
VPLL pin
VCCIO pins
(15k/4.7k+1)*0.6V = 2.5V
Test Points & LEDs
Power
VCORE pins
VPHY pin
(15k/18k+1)*0.6V = +1V1
VDD1.8 pin
USB ULPI
Rx LED
FTDI, USB ULPI & Power
USB3318C is powered from the external +3V3 supply. The internal USB3318C LDO is not used.
Tx LED
VDDIO pin
VBAT pin
FT2232HQ
(15k/3.3k+1)*0.6V = 3.32V

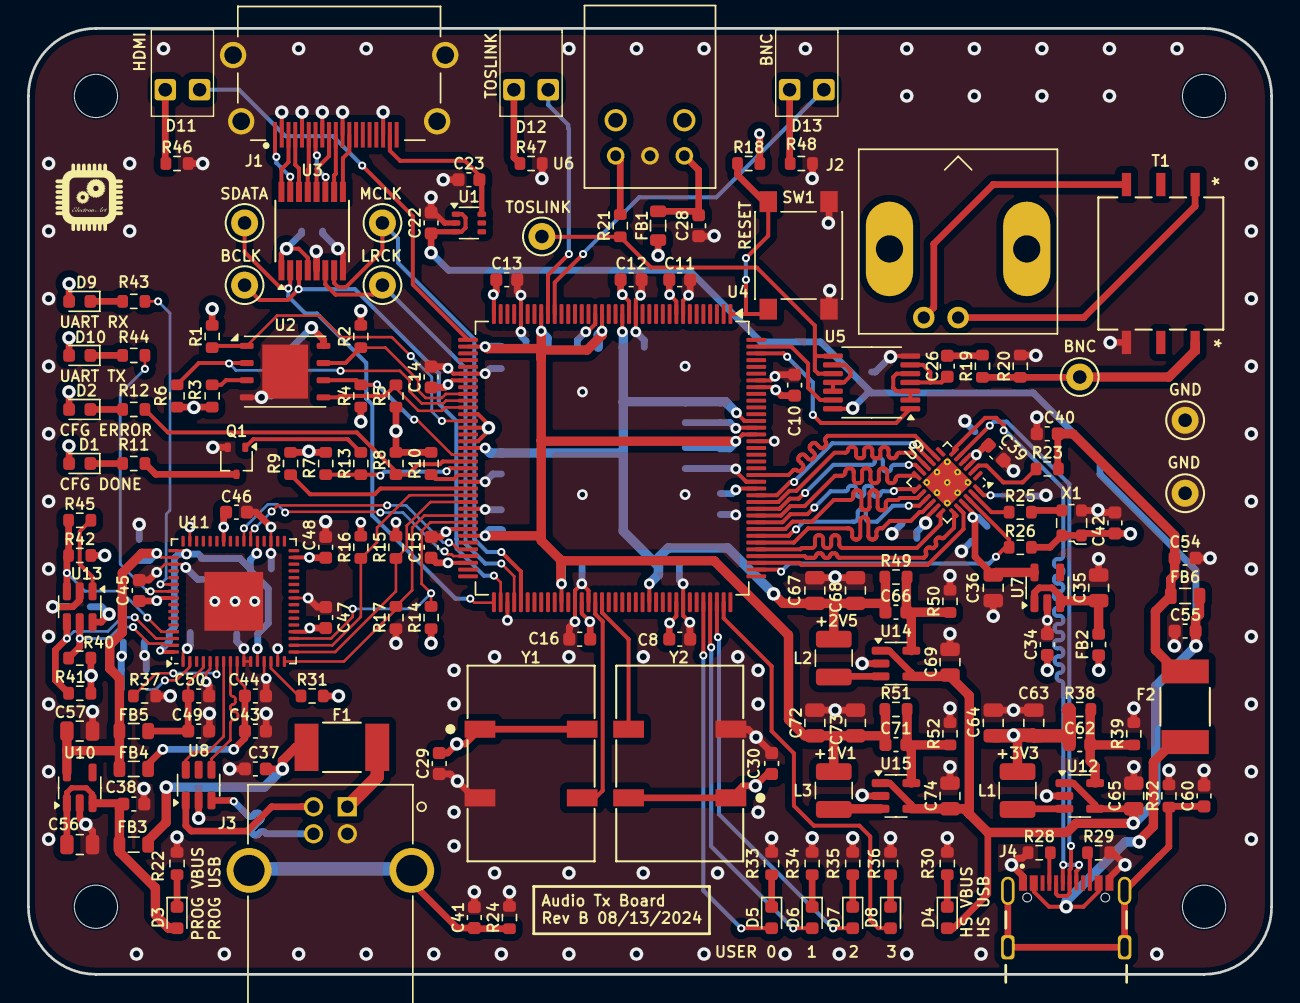
[picture p19: board ECP5_Audio.kicad_pcb from above]

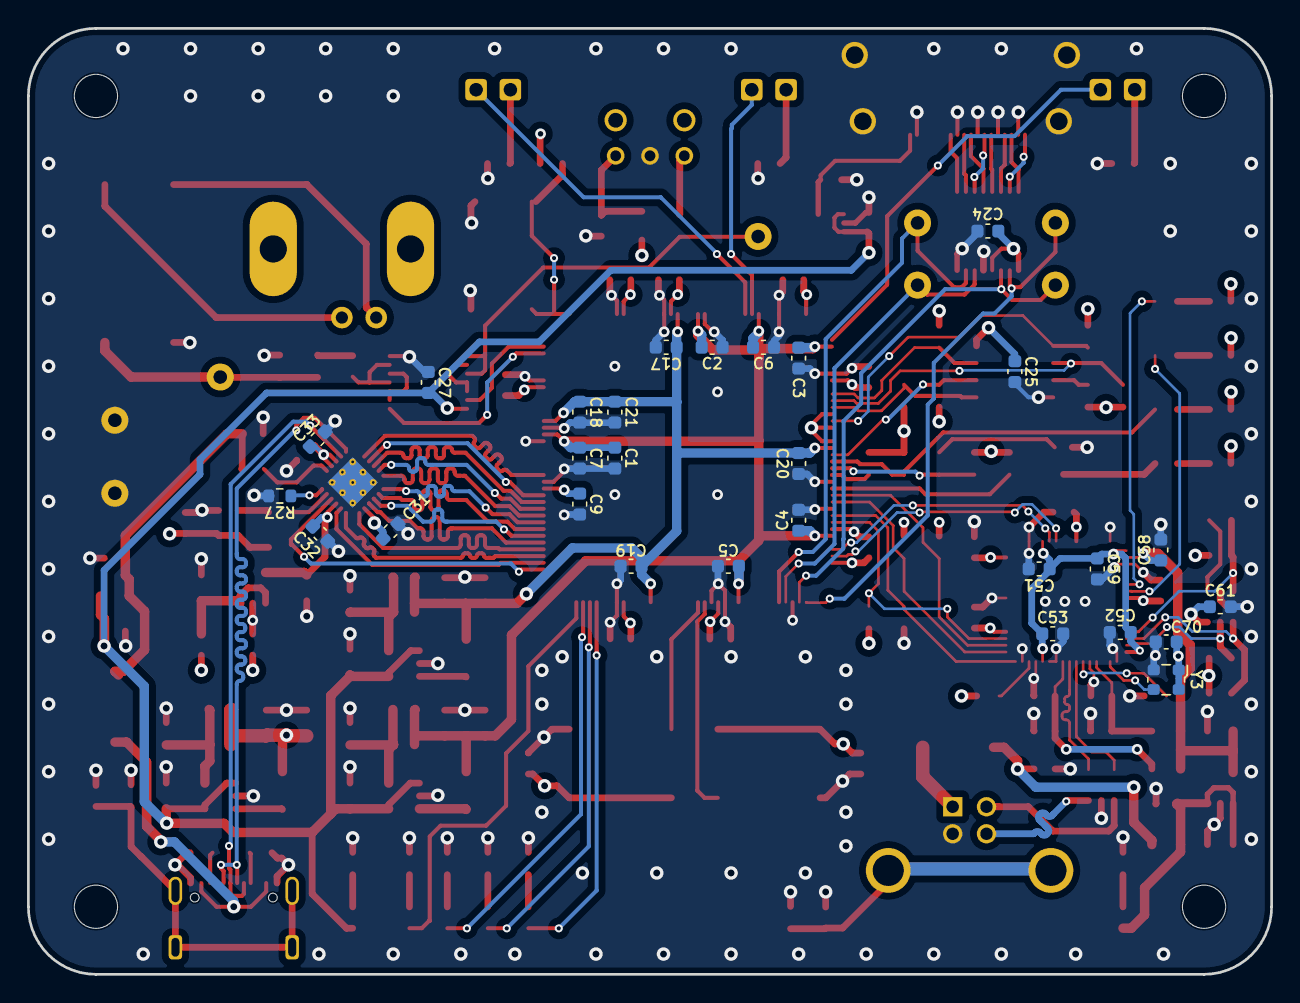
[picture p20: board ECP5_Audio.kicad_pcb from below]

Board: 4 copper layers, 92.0 x 70.0 mm, 188 parts (28 on the bottom side), 124 nets.

Other parts of the board:
H1, H2, H3, H4: MountingHole; MountingHole_3.2mm_M3
