gildobjanschi/ECP5_TQFP144_USB3318C_TX_AUDIO/(commit log)

2024-07-15 Moved 8.06K resistor close to USB3318C
    Moved 8.06K resistor close to USB3318C
    [ECP5_Audio.kicad_pcb]
2024-07-16 Prepared submission to PCBWay
    [ECP5_Audio.kicad_pcb]
2024-07-16 Upgraded to ECP5-25K
    [ECP5.kicad_sch]
2024-08-13 5.1K USB resistors
    Replaces 22K resistors to VBUS with 5.1K resistors to GND.
    [ECP5.kicad_sch, ECP5_Audio.kicad_pcb, ULPI_FT2232H_POWER.kicad_sch]
2024-08-13 Updated ROM symbol
    [ECP5.kicad_sch, ECP5_Audio.kicad_pcb]
2024-08-14 Delete STM32H723.kicad_sch
    Remove unused file.
    [STM32H723.kicad_sch]
