gildobjanschi/ECP5_TQFP144_USB3318C_TX_AUDIO/(notices)

Notices in the files:
3dmodels/W-PDFN-8-1EP_6x5mm_P1.27mm_EP3x3mm.step:
Copyright (C) 2022, KiCAD
This work is licensed under the
[Creative Commons CC-BY-SA 4.0 License](https://creativecommons.org/licenses/by-sa/4.0/legalcode),
with the following exception:
project files under this or any other license agreement. However, if you wish to distribute
